y-suyama/FlexLogicMini_EVB/README.md

# FlexLogicMini Evalution Board
# Revision
## First Version

FTDI Driver Install
Thonny
tearteam
