y-suyama/FlexLogicMini_EVB/usrlib/LCMXO2-1200HC-4SG32I/LCMXO2-1200HC-4SG32I.stp

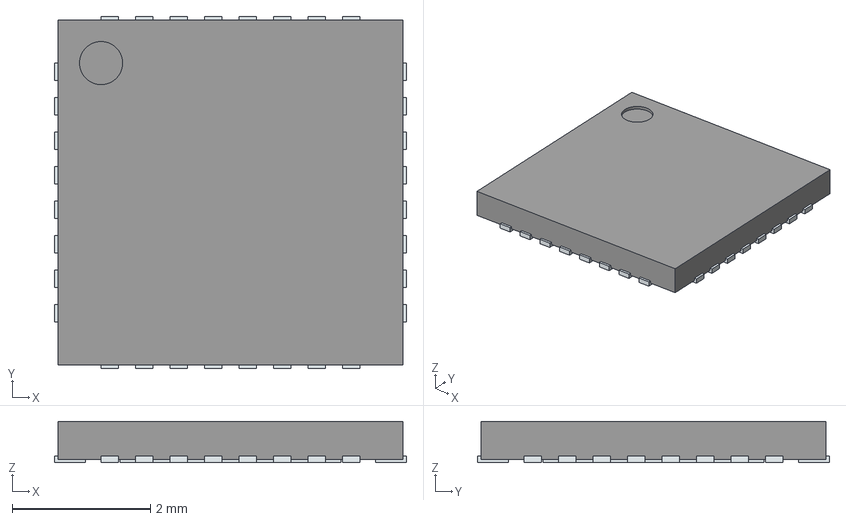
[picture p1: CAD file, 2025-06-15]
usrlib/LCMXO2-1200HC-4SG32I/LCMXO2-1200HC-4SG32I.stp
5.10 x 5.10 x 0.6 mm
ThermalPin
PinsArrayLR
PinsArrayTB
