y-suyama/FlexLogicMini_EVB/usrlib/SKRPACE010/SKRPACE010.step

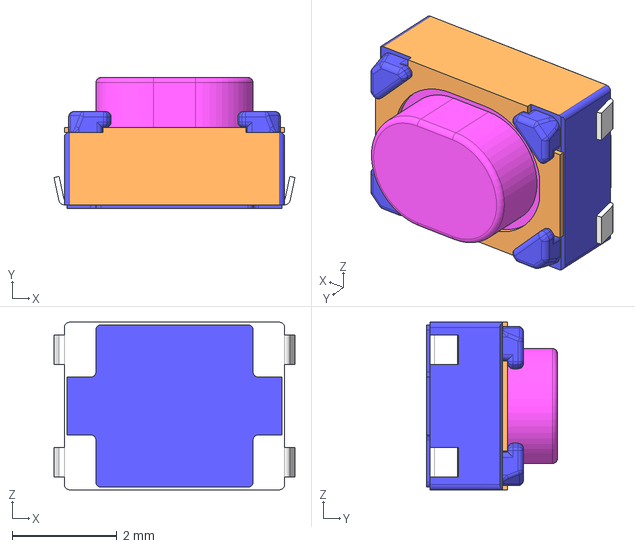
[picture p2: CAD file, 2025-06-15]
usrlib/SKRPACE010/SKRPACE010.step
4.60 x 2.50 x 3.20 mm
