y-suyama/FlexLogicMini_EVB/usrlib/UJC-HP-3-SMT-TR/UJC-HP-3-SMT-TR.step

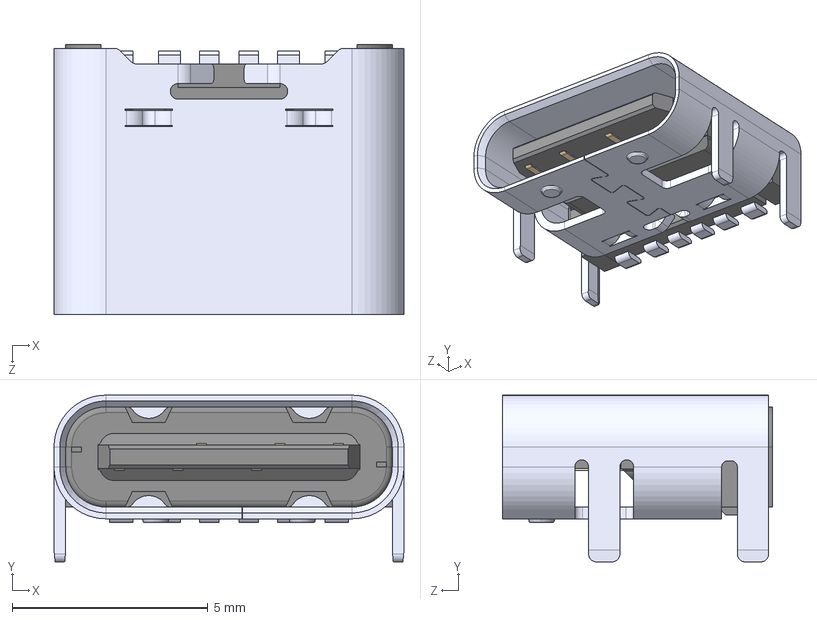
[picture p3: CAD file, 2025-06-15]
usrlib/UJC-HP-3-SMT-TR/UJC-HP-3-SMT-TR.step
8.94 x 4.26 x 6.90 mm
