y-suyama/FlexLogicMini_EVB/usrlib/W25Q16JVUXiQ/W25Q16JVUXIQ.step

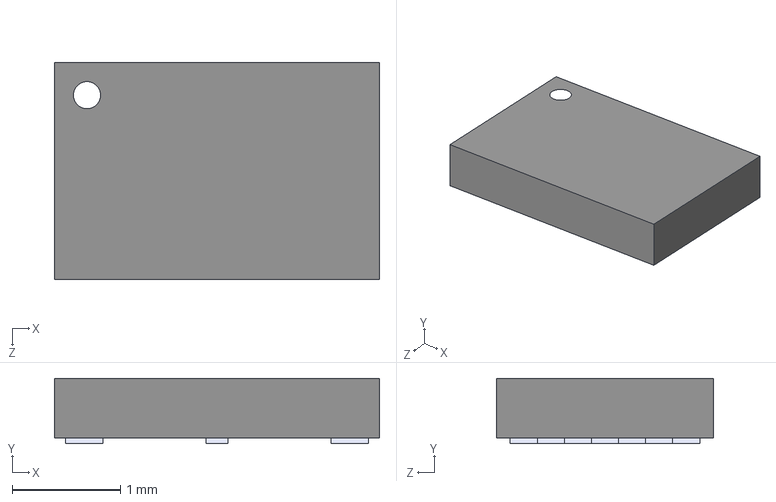
[picture p4: CAD file, 2025-06-15]
usrlib/W25Q16JVUXiQ/W25Q16JVUXIQ.step
3.00 x 0.6 x 2.00 mm
