y-suyama/FlexLogicMini_EVB/FlexLogicMini_EVB_schematic.pdf

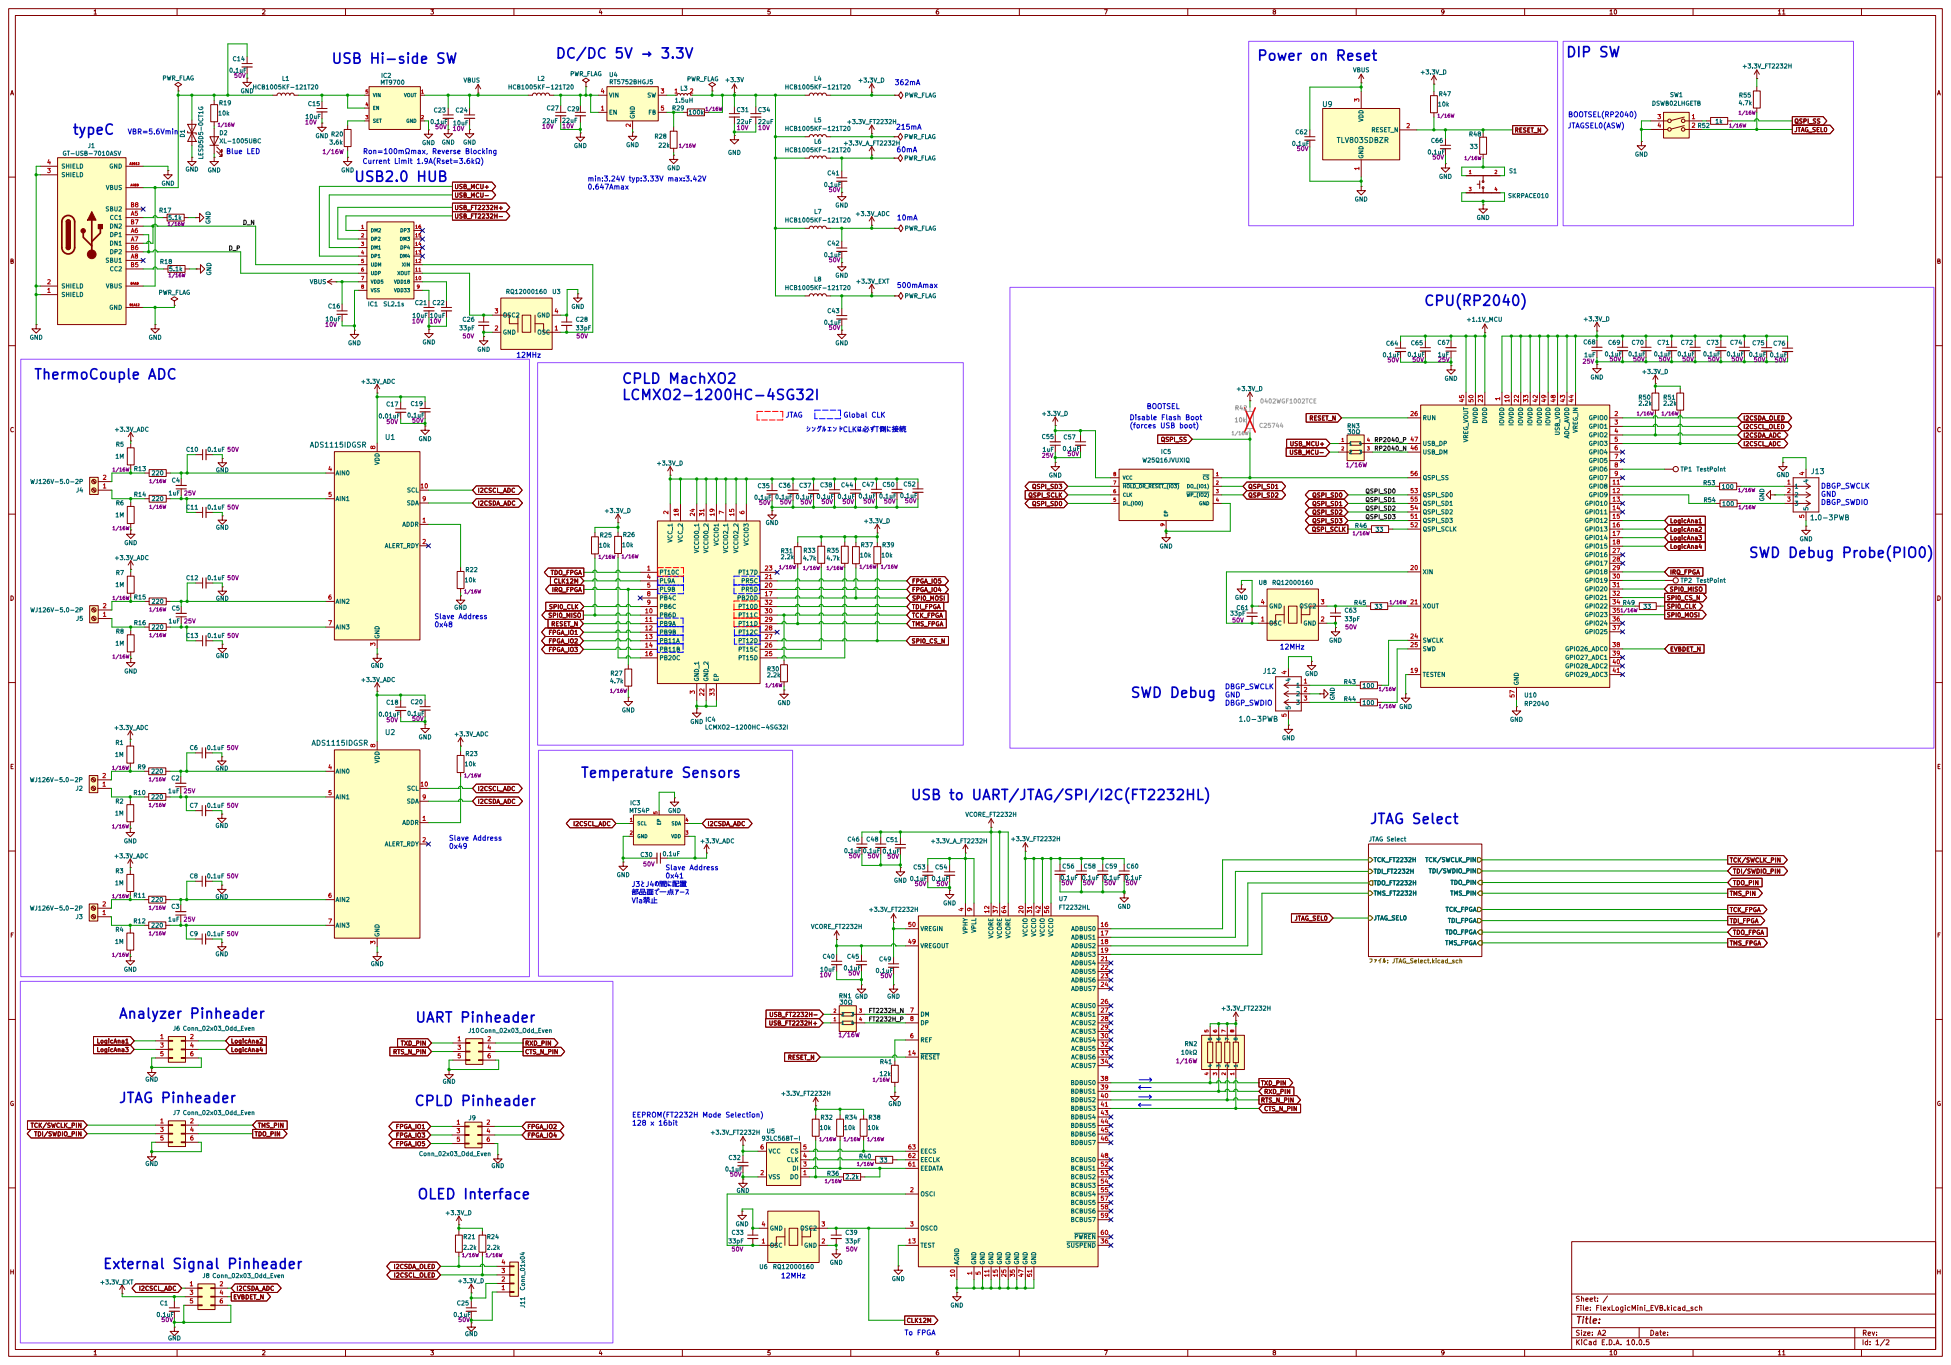
[picture p5: page 1]

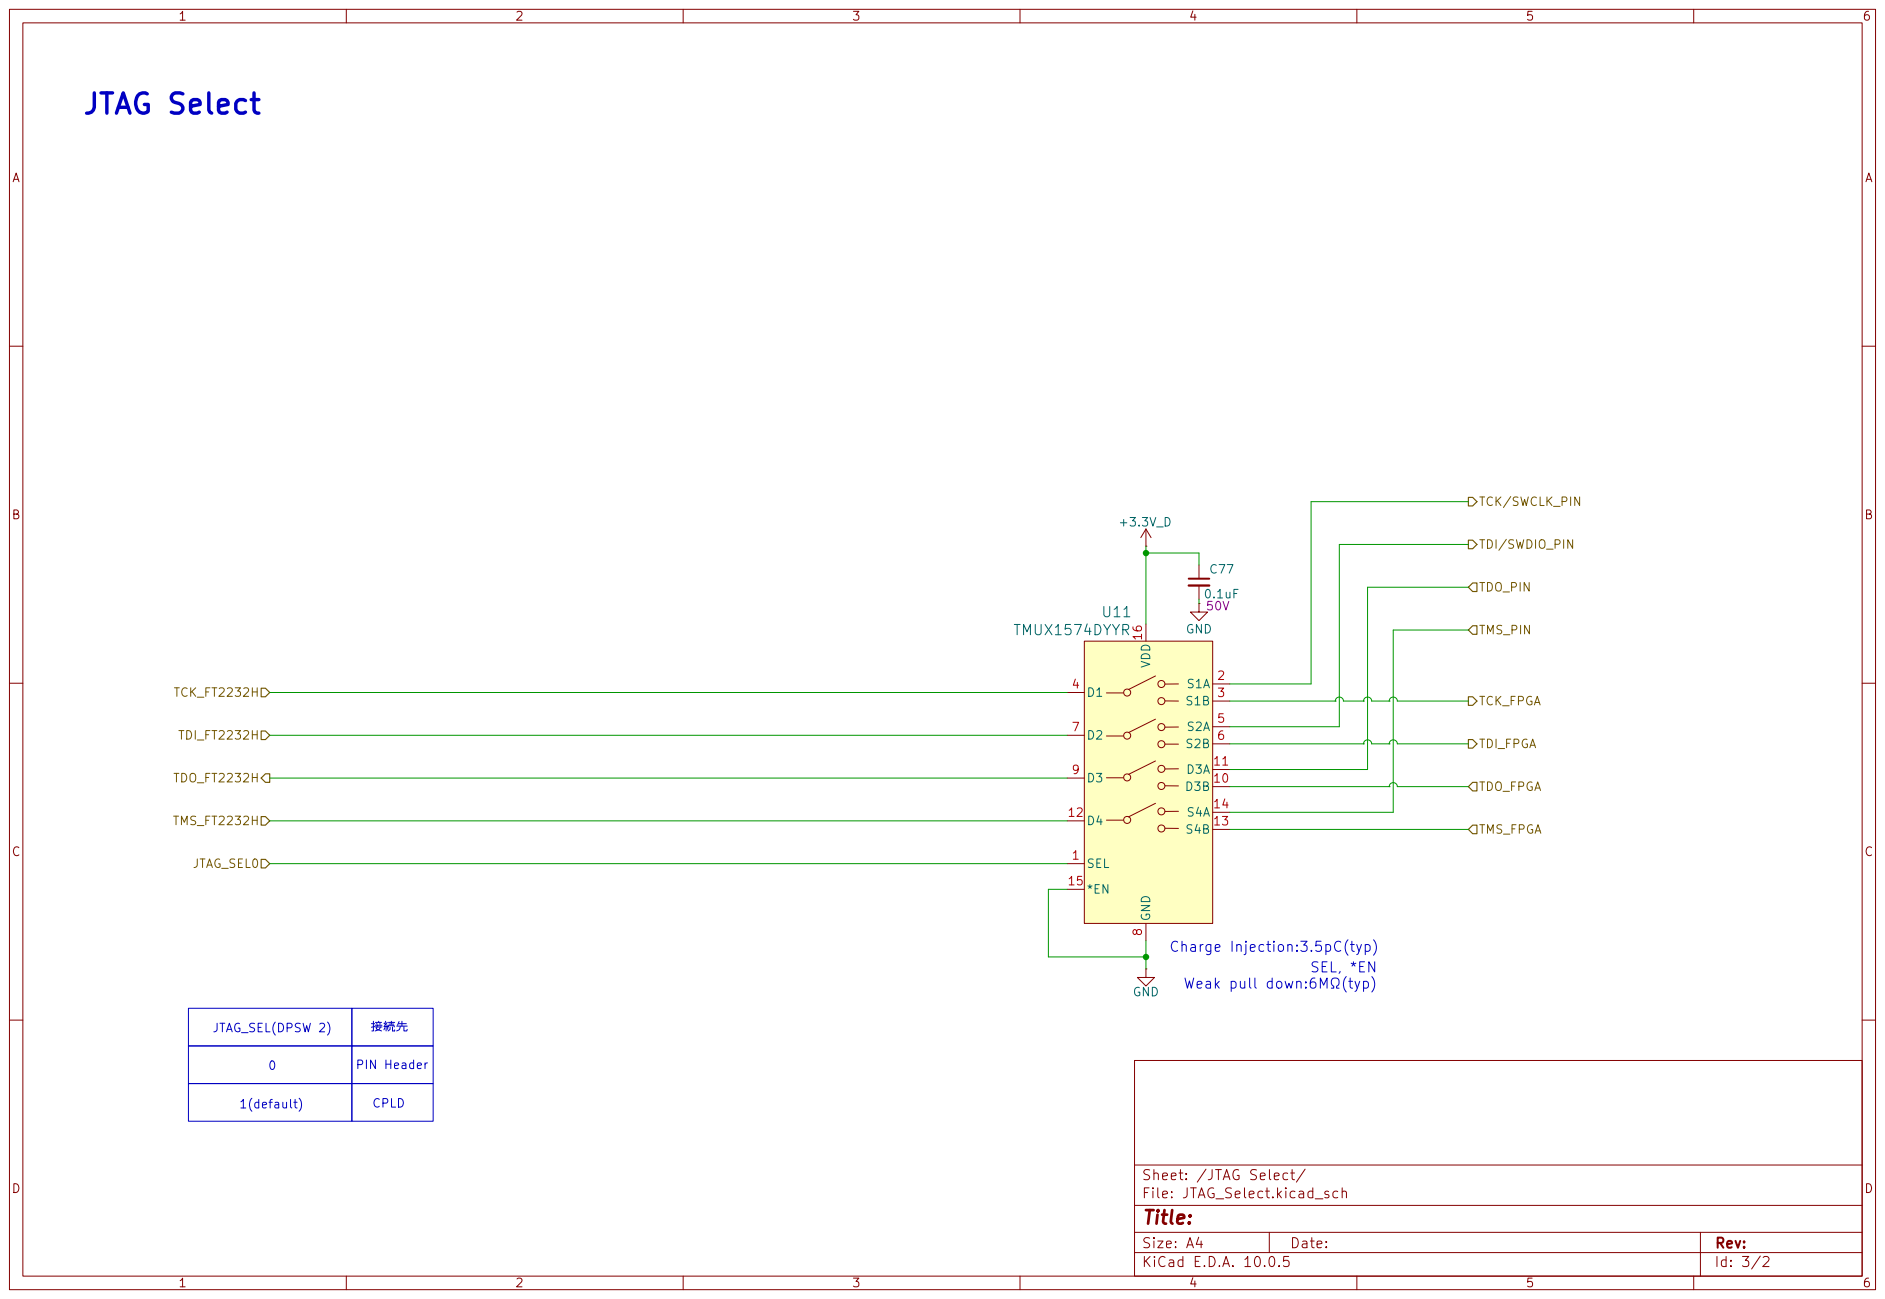
[picture p6: page 2]
