y-suyama/FlexLogicMini_EVB/FlexLogicMini_EVB_PCB.pdf

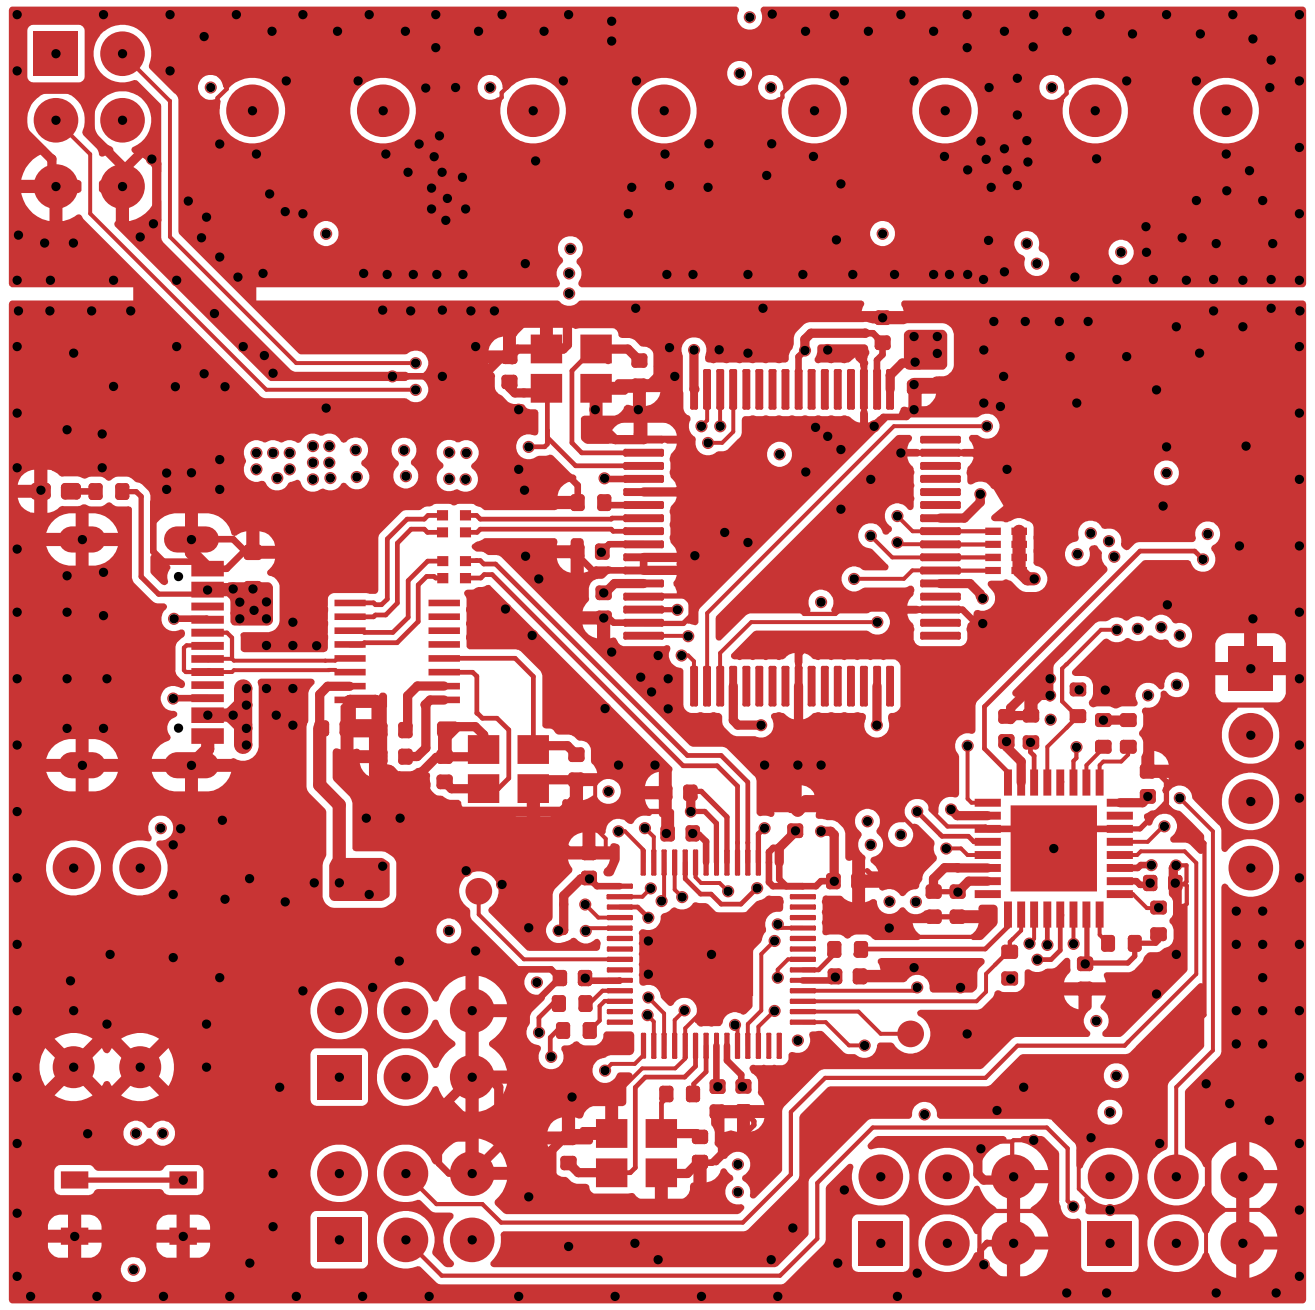
[picture p7: page 1]

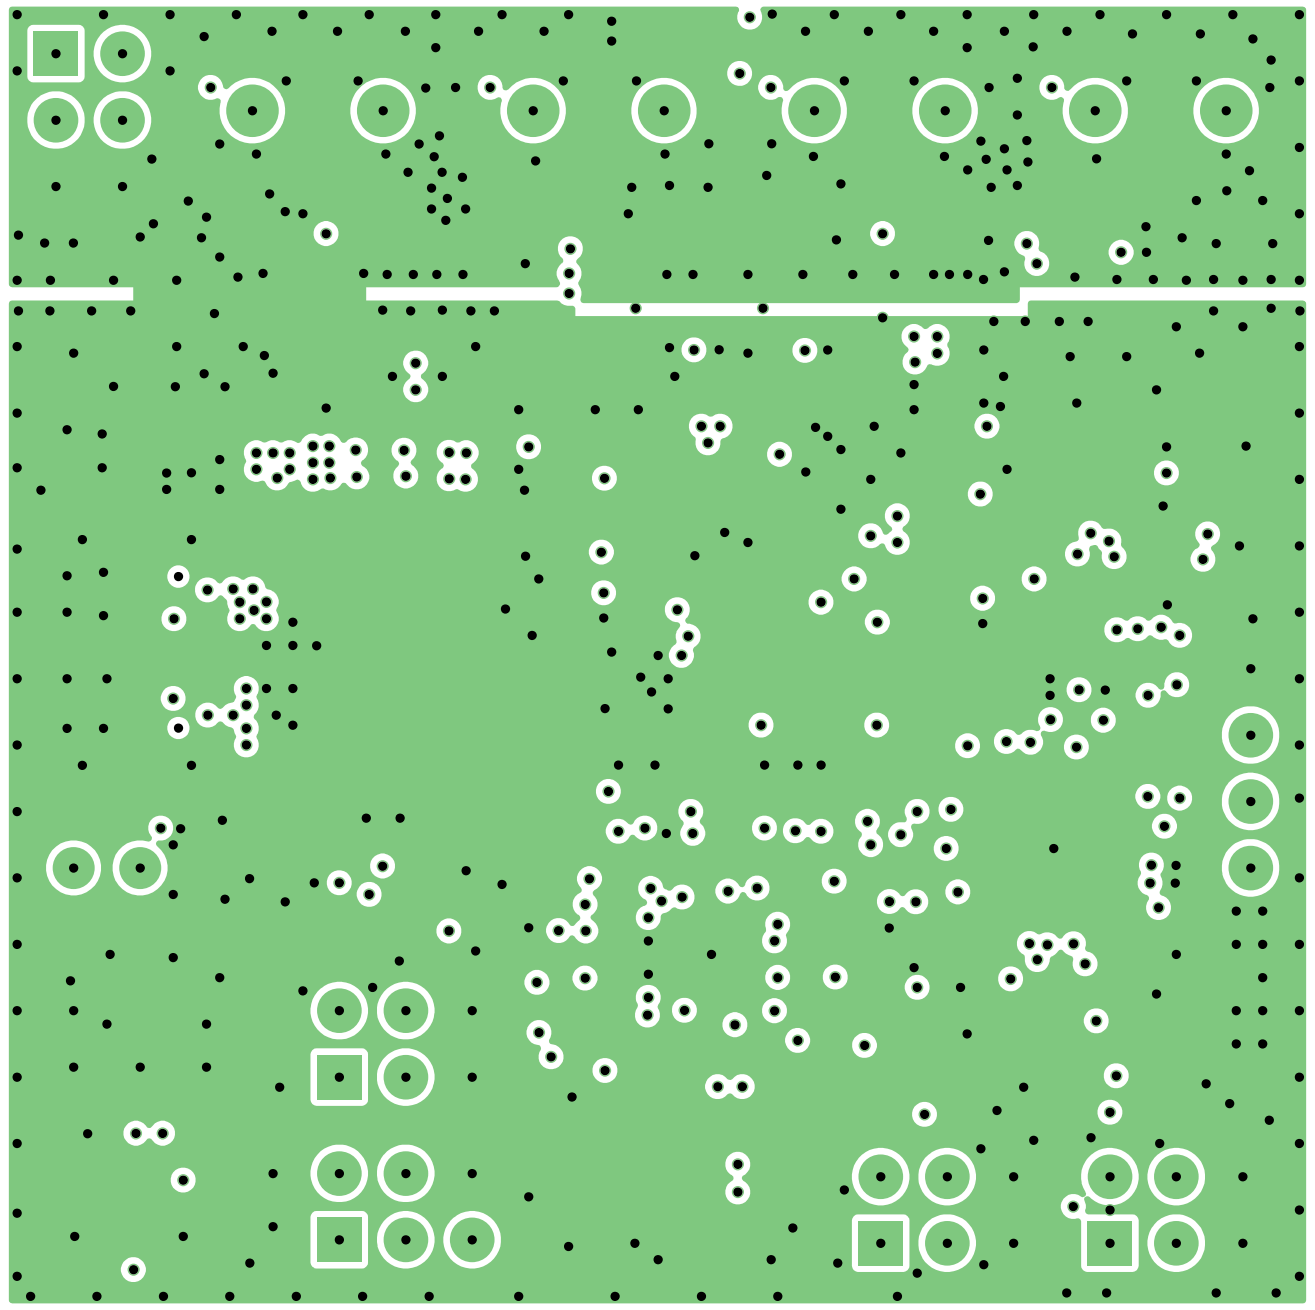
[picture p8: page 2]

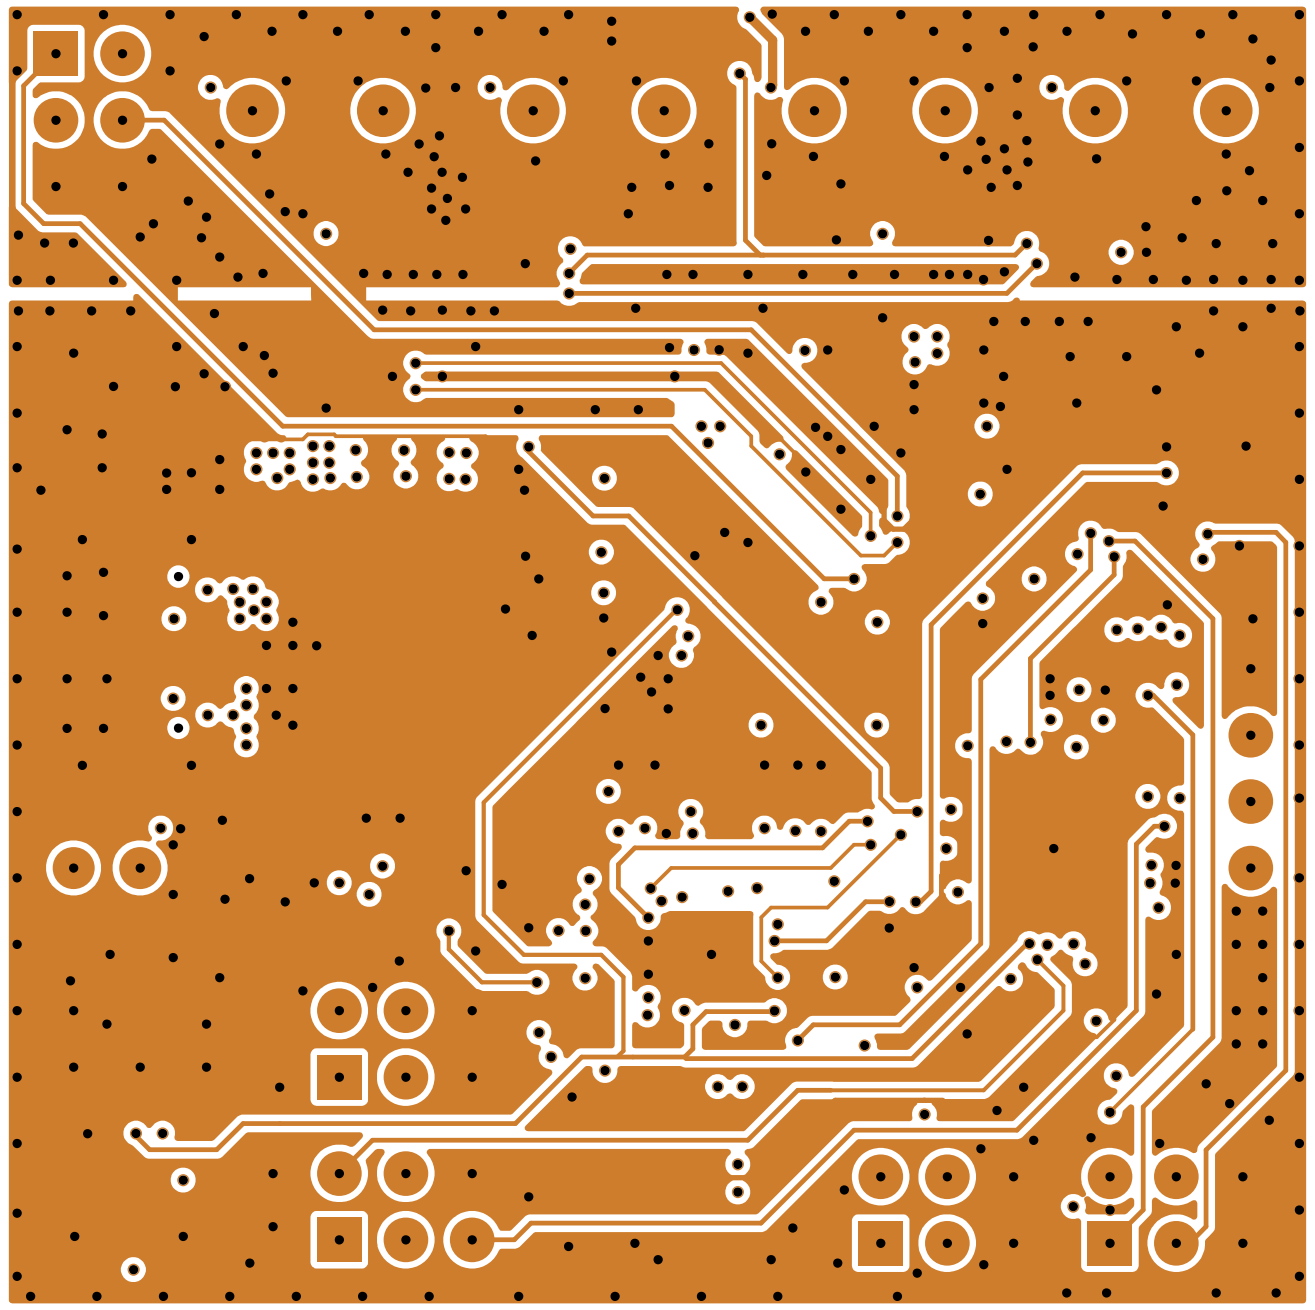
[picture p9: page 3]

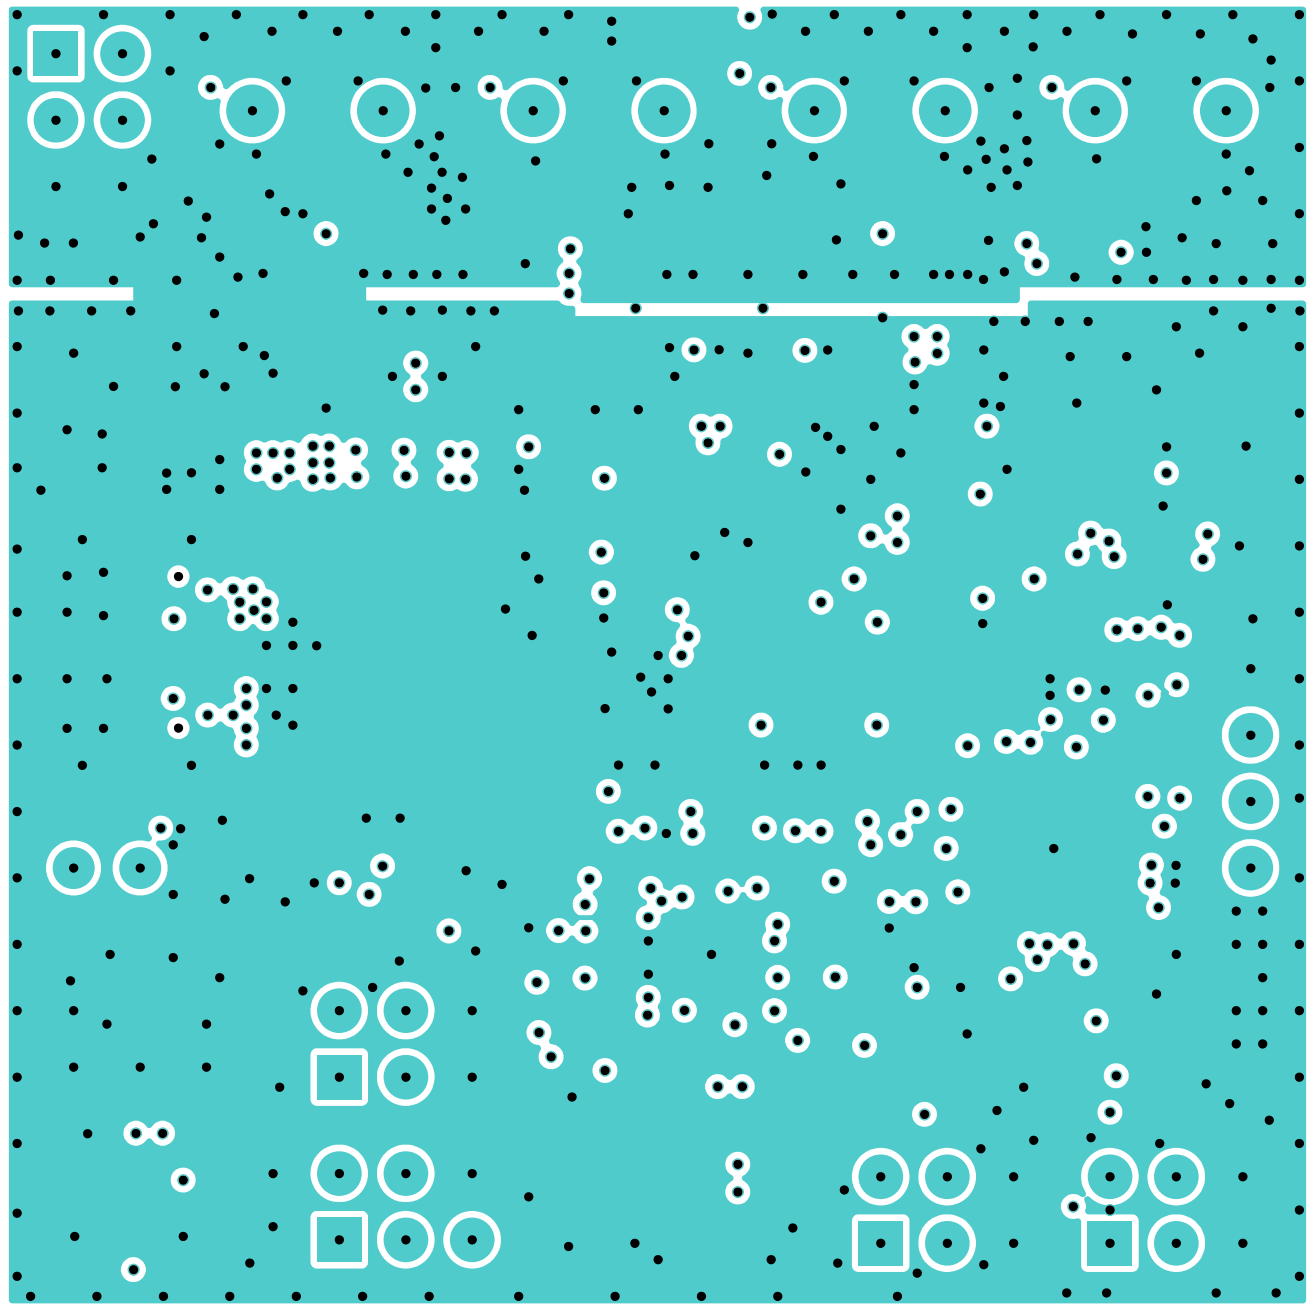
[picture p10: page 4]

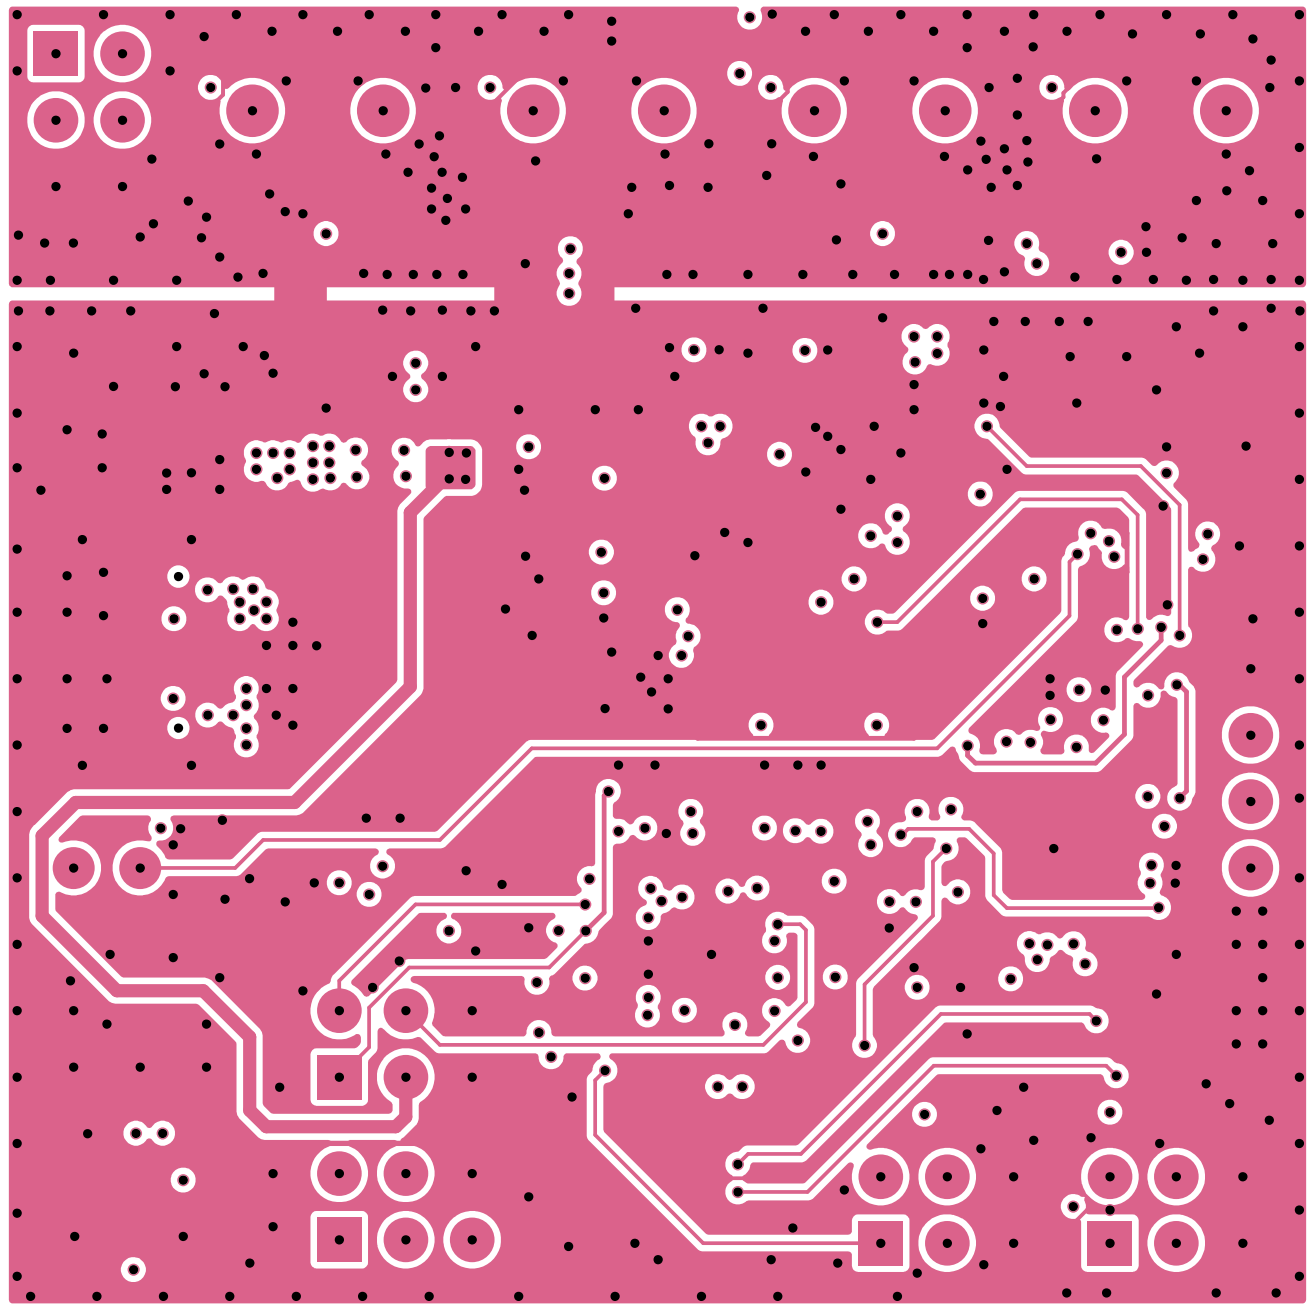
[picture p11: page 5]

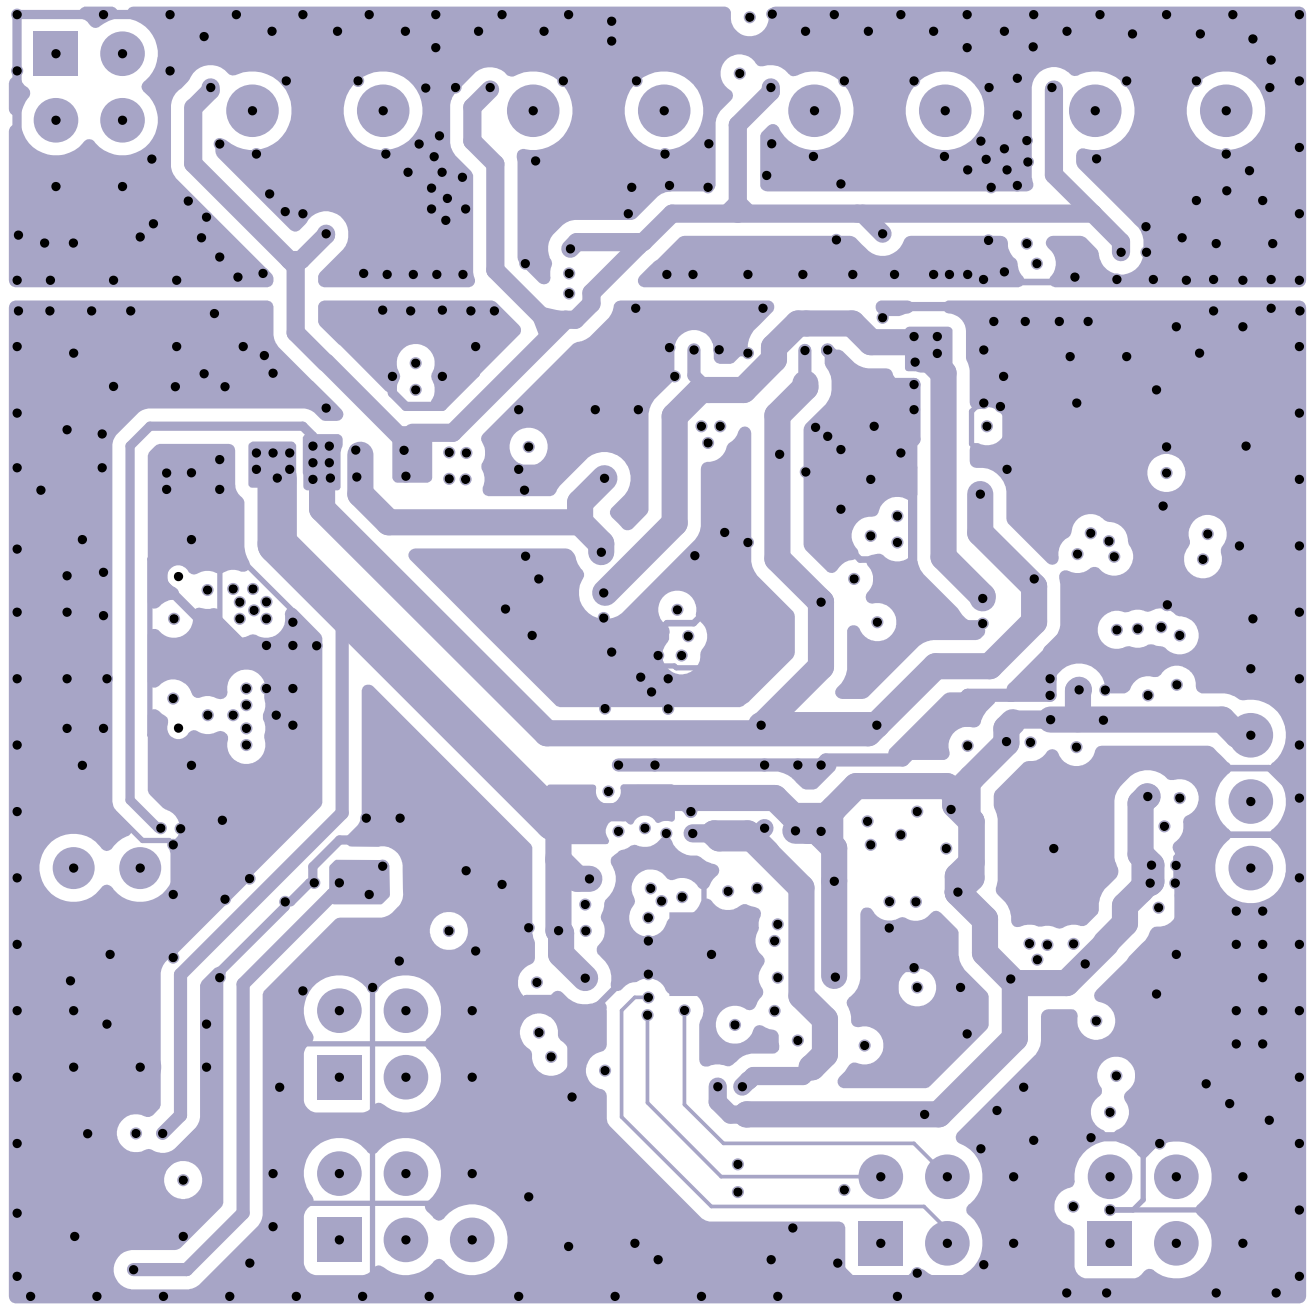
[picture p12: page 6]

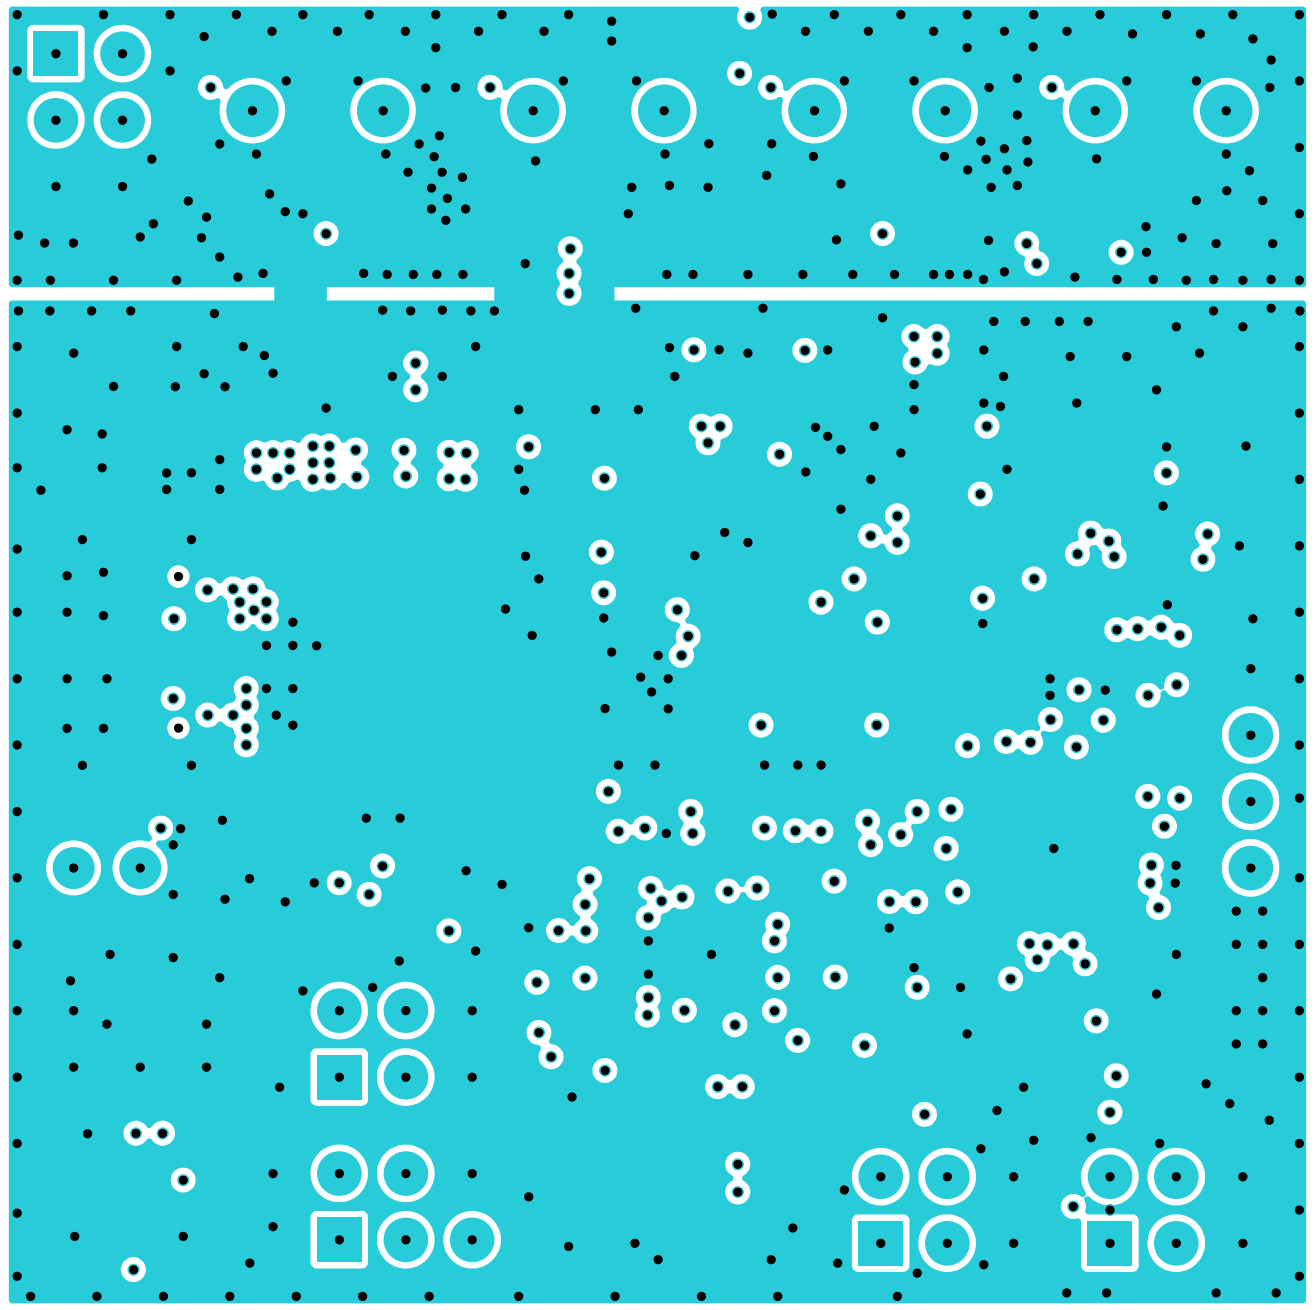
[picture p13: page 7]

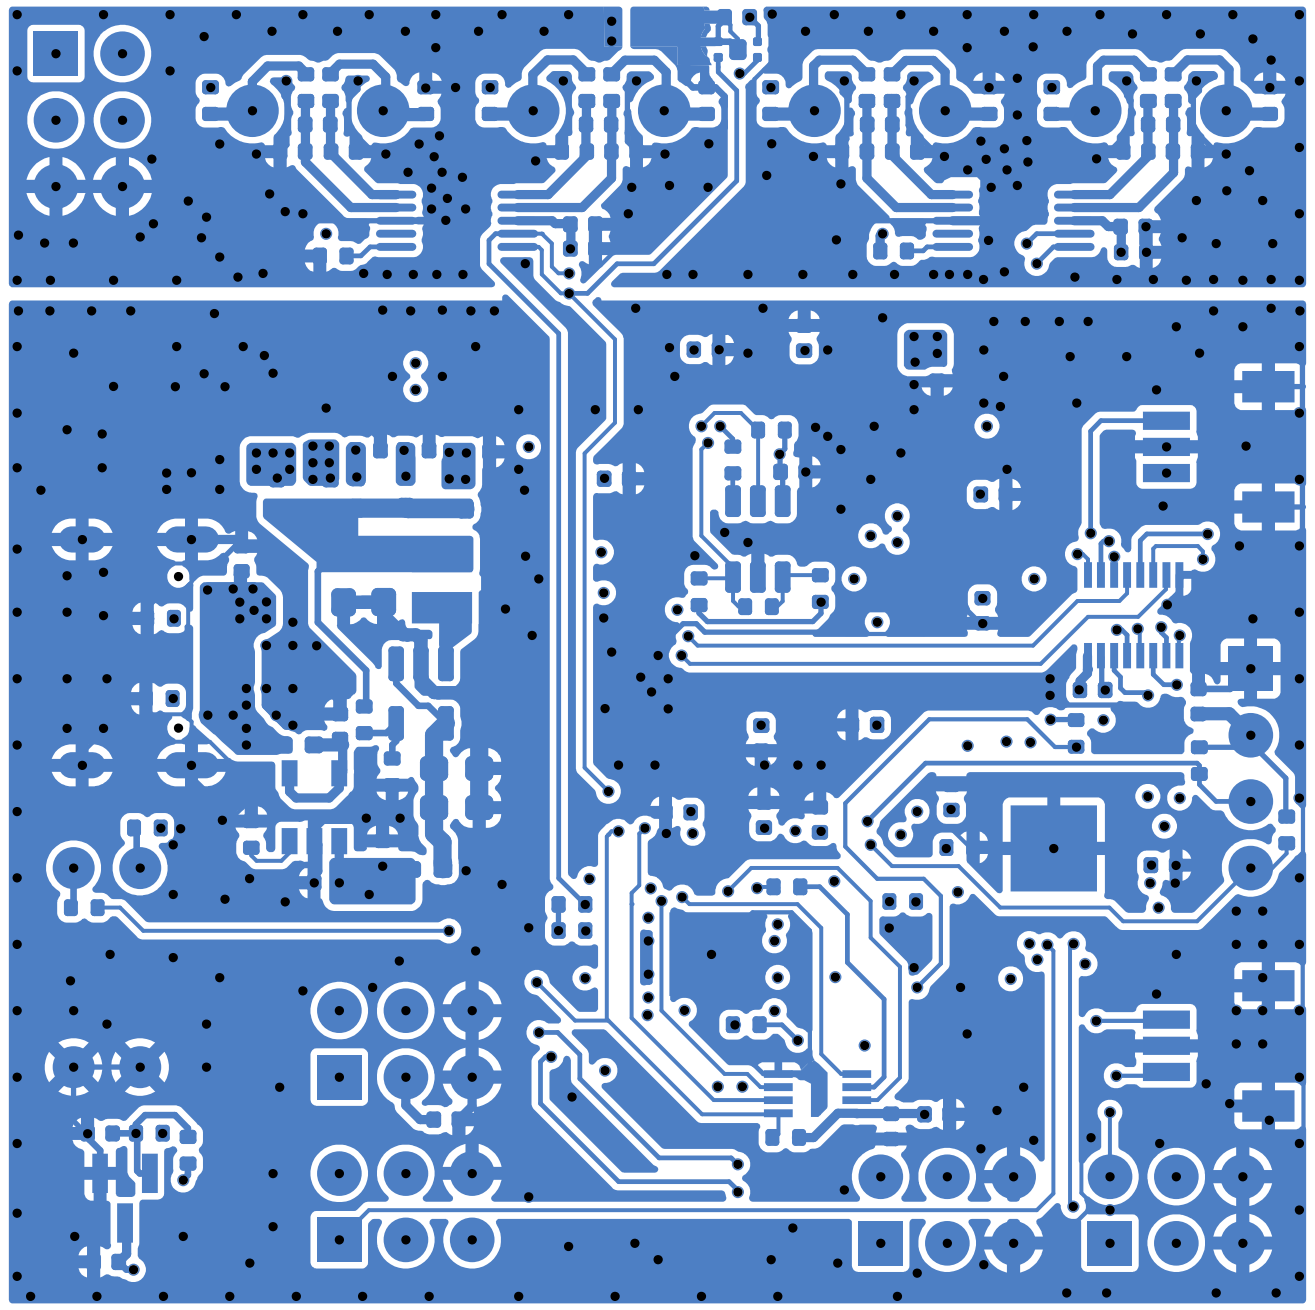
[picture p14: page 8]

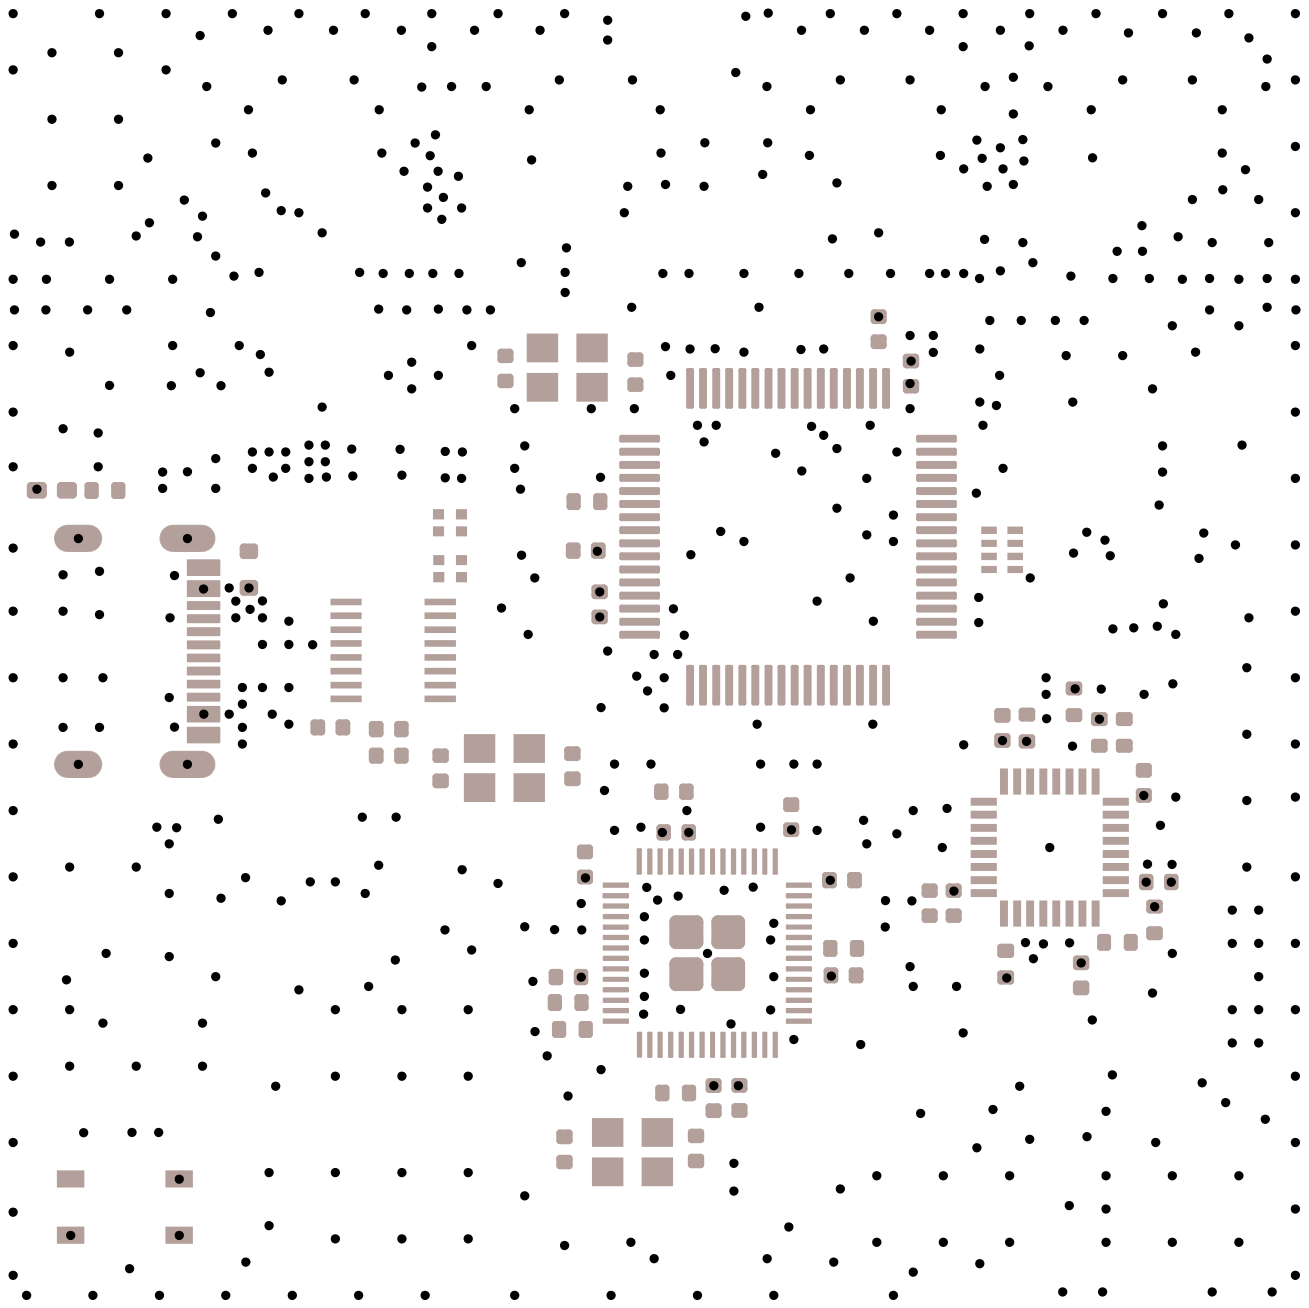
[picture p15: page 9]

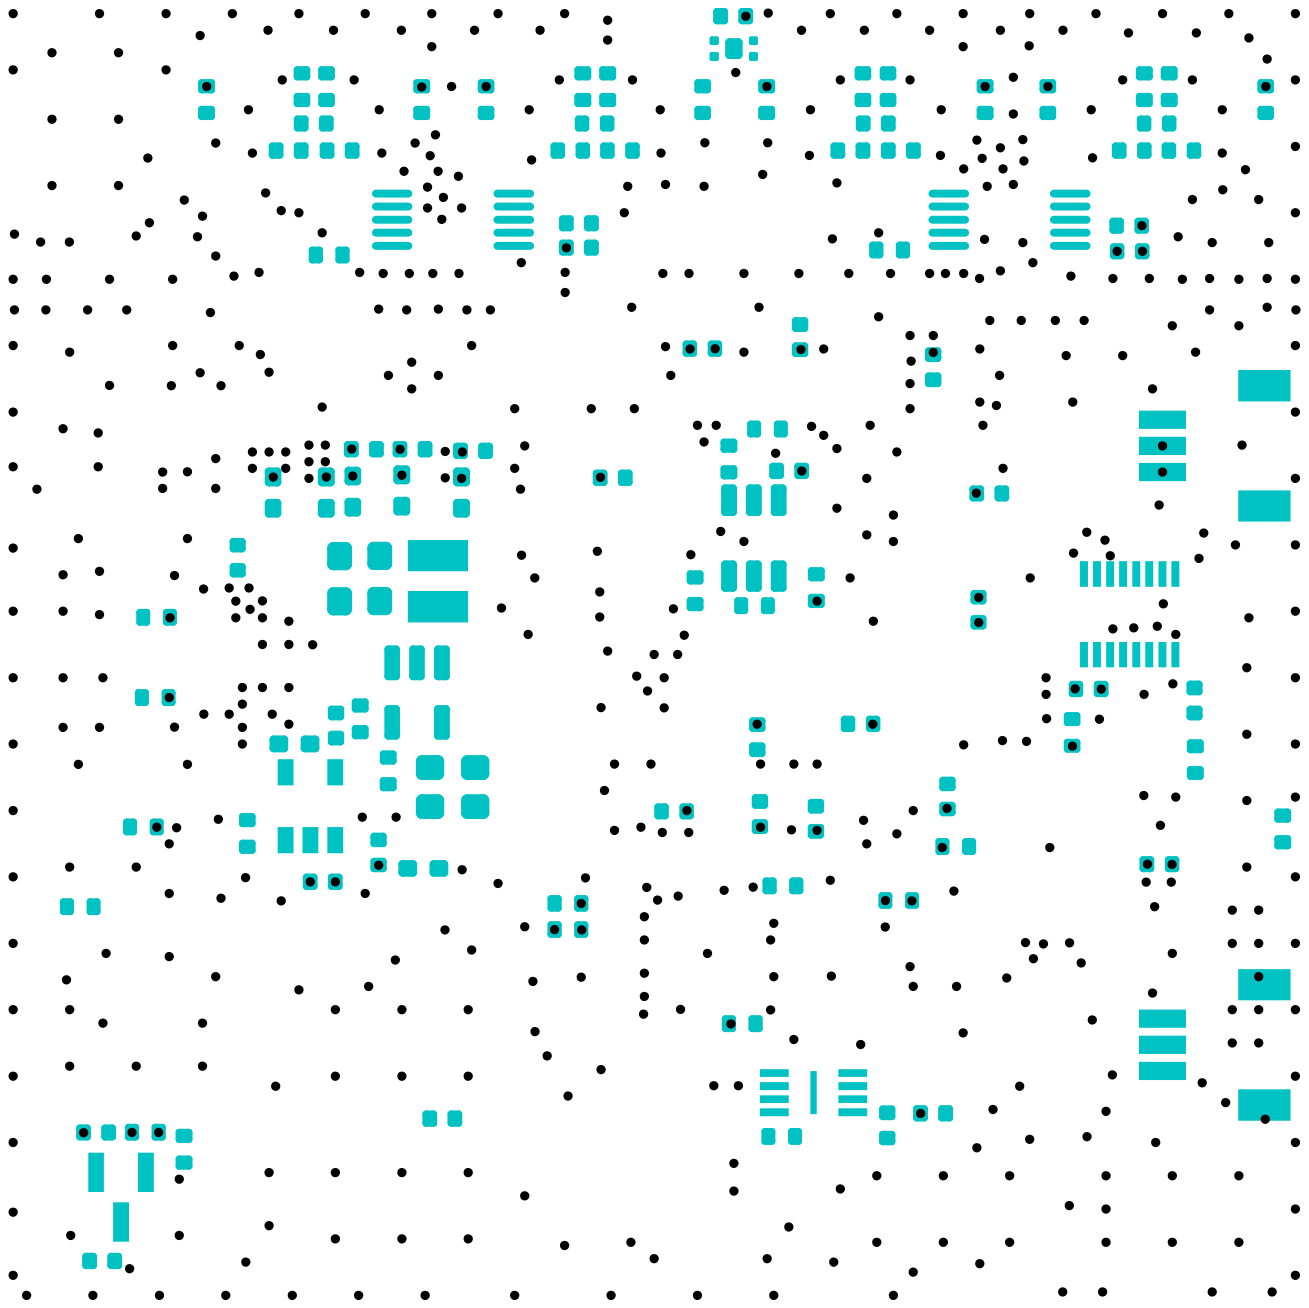
[picture p16: page 10]

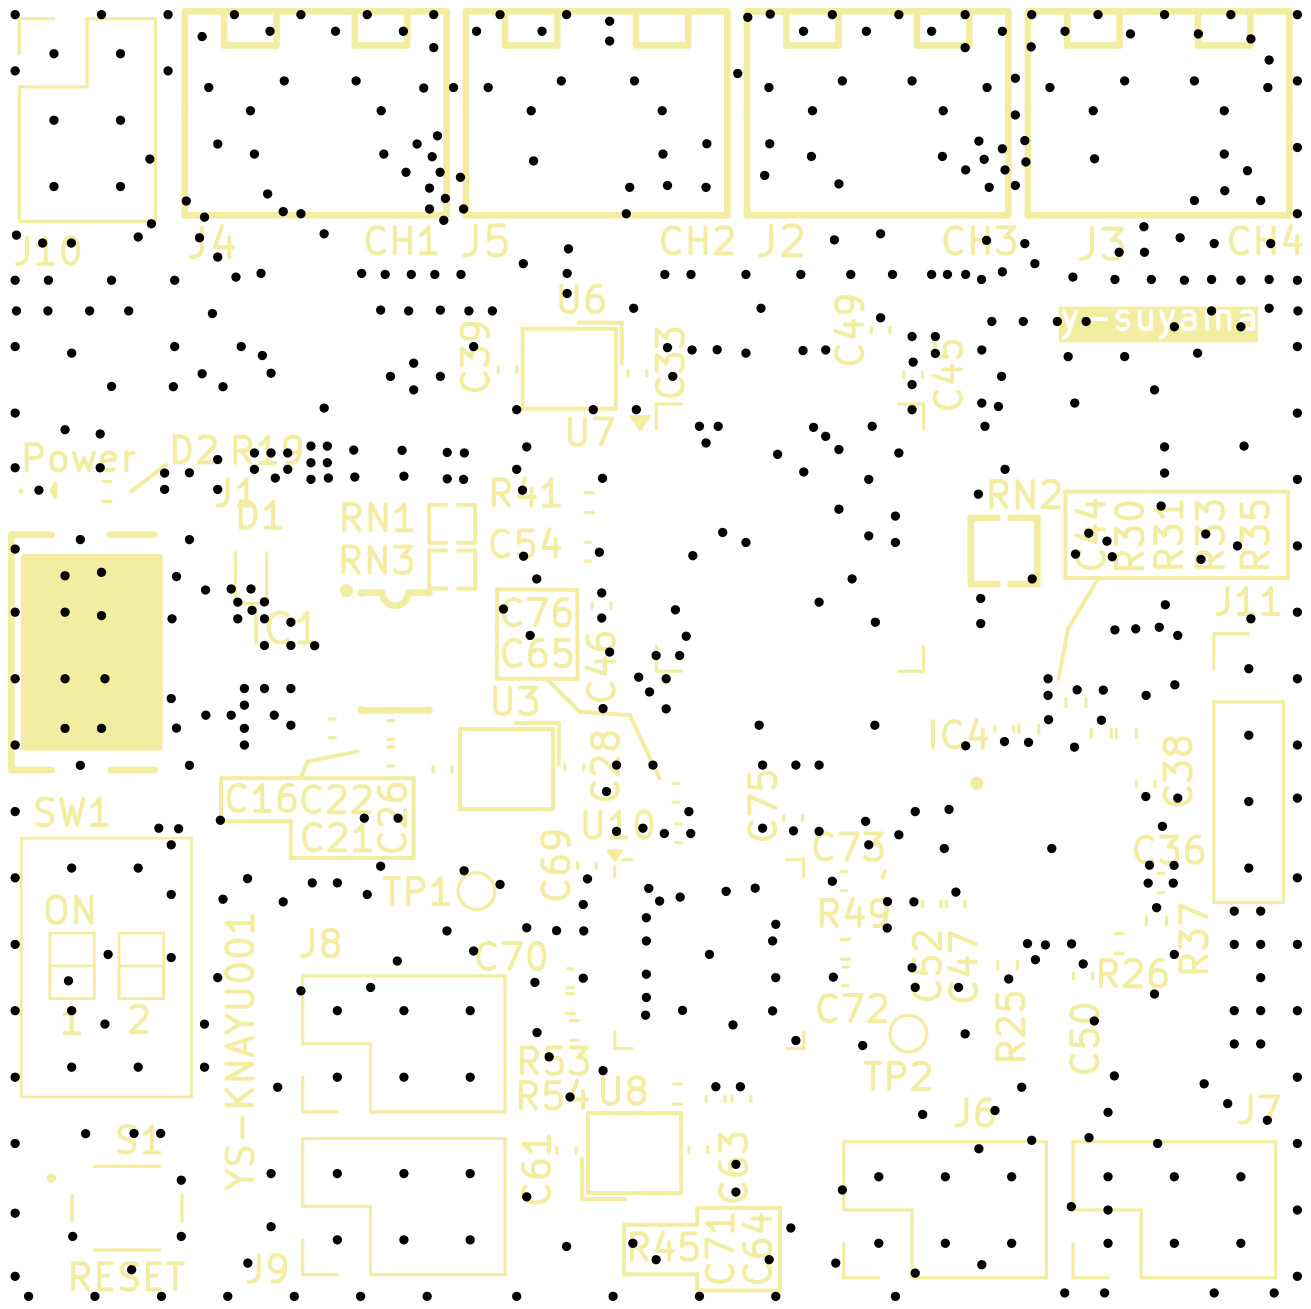
[picture p17: page 11]

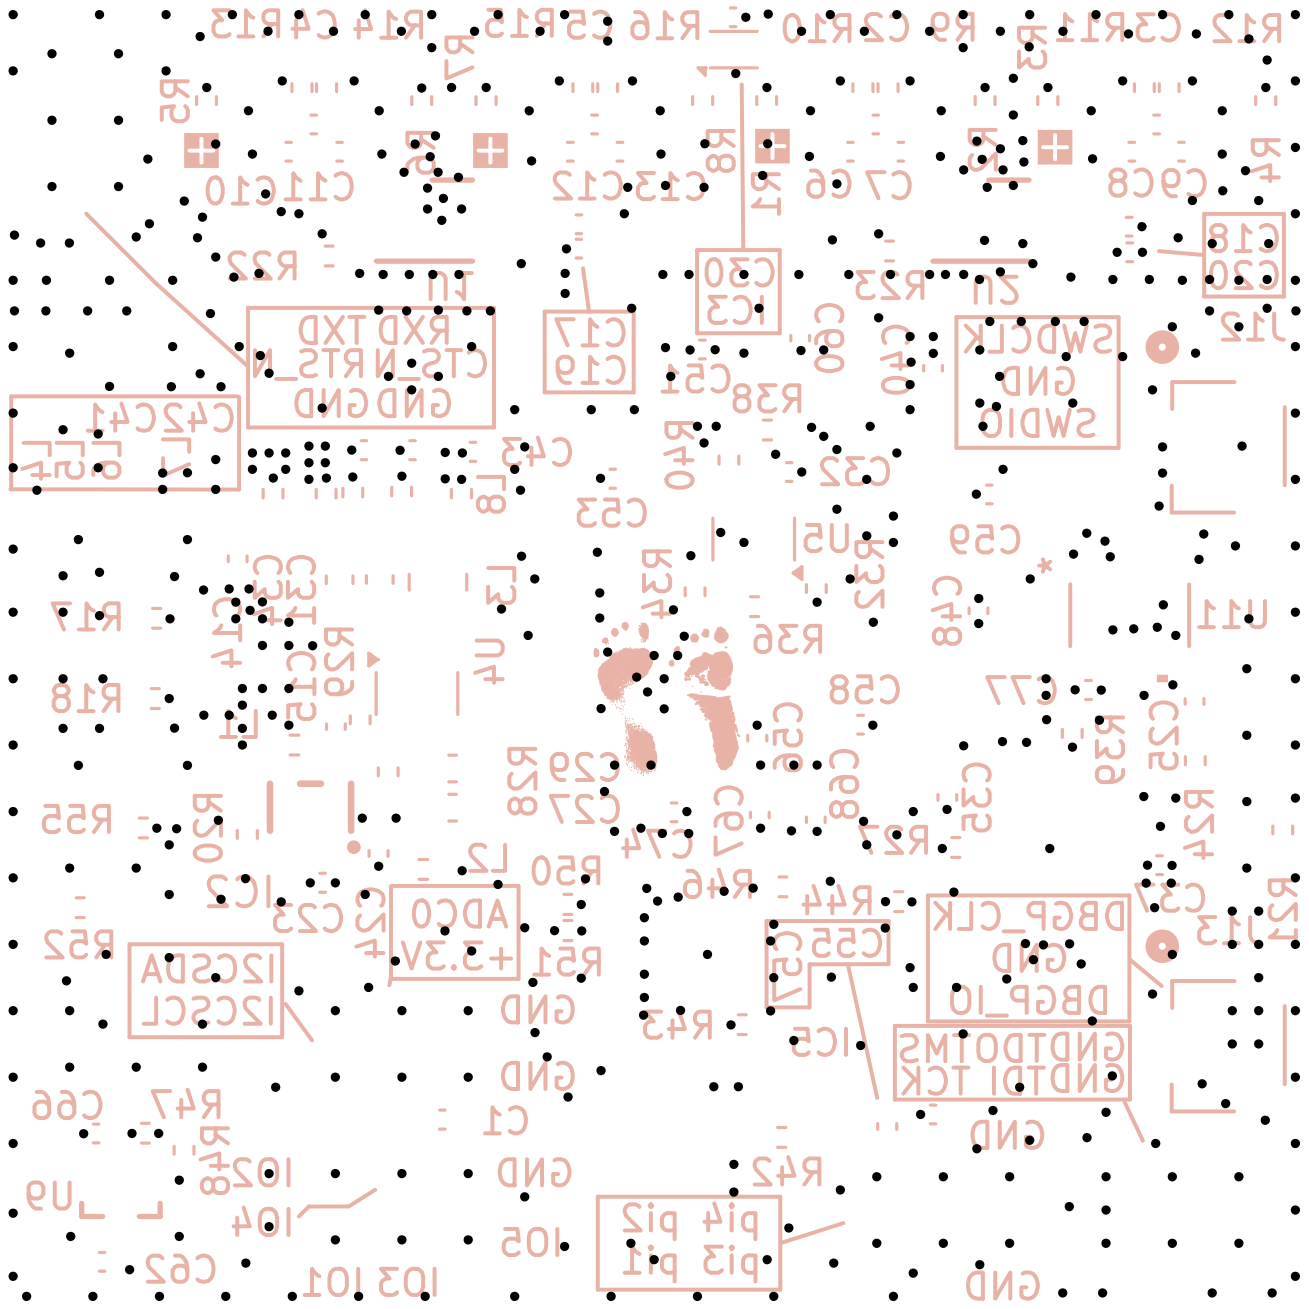
[picture p18: page 12]

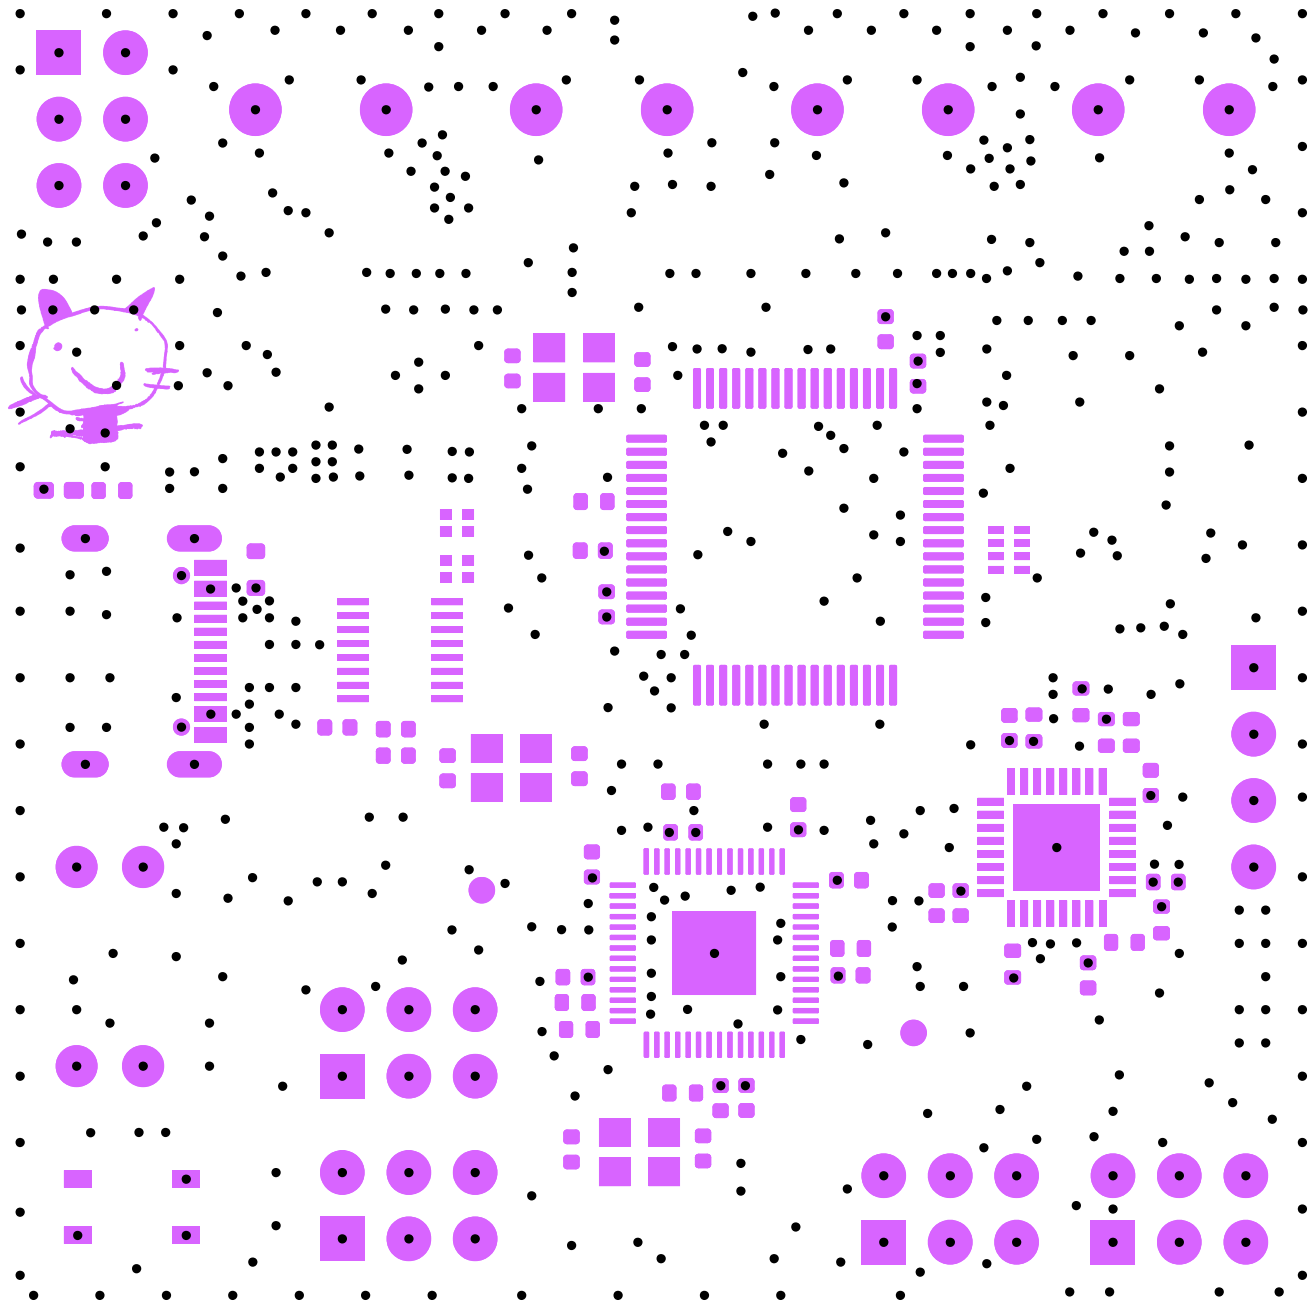
[picture p19: page 13]

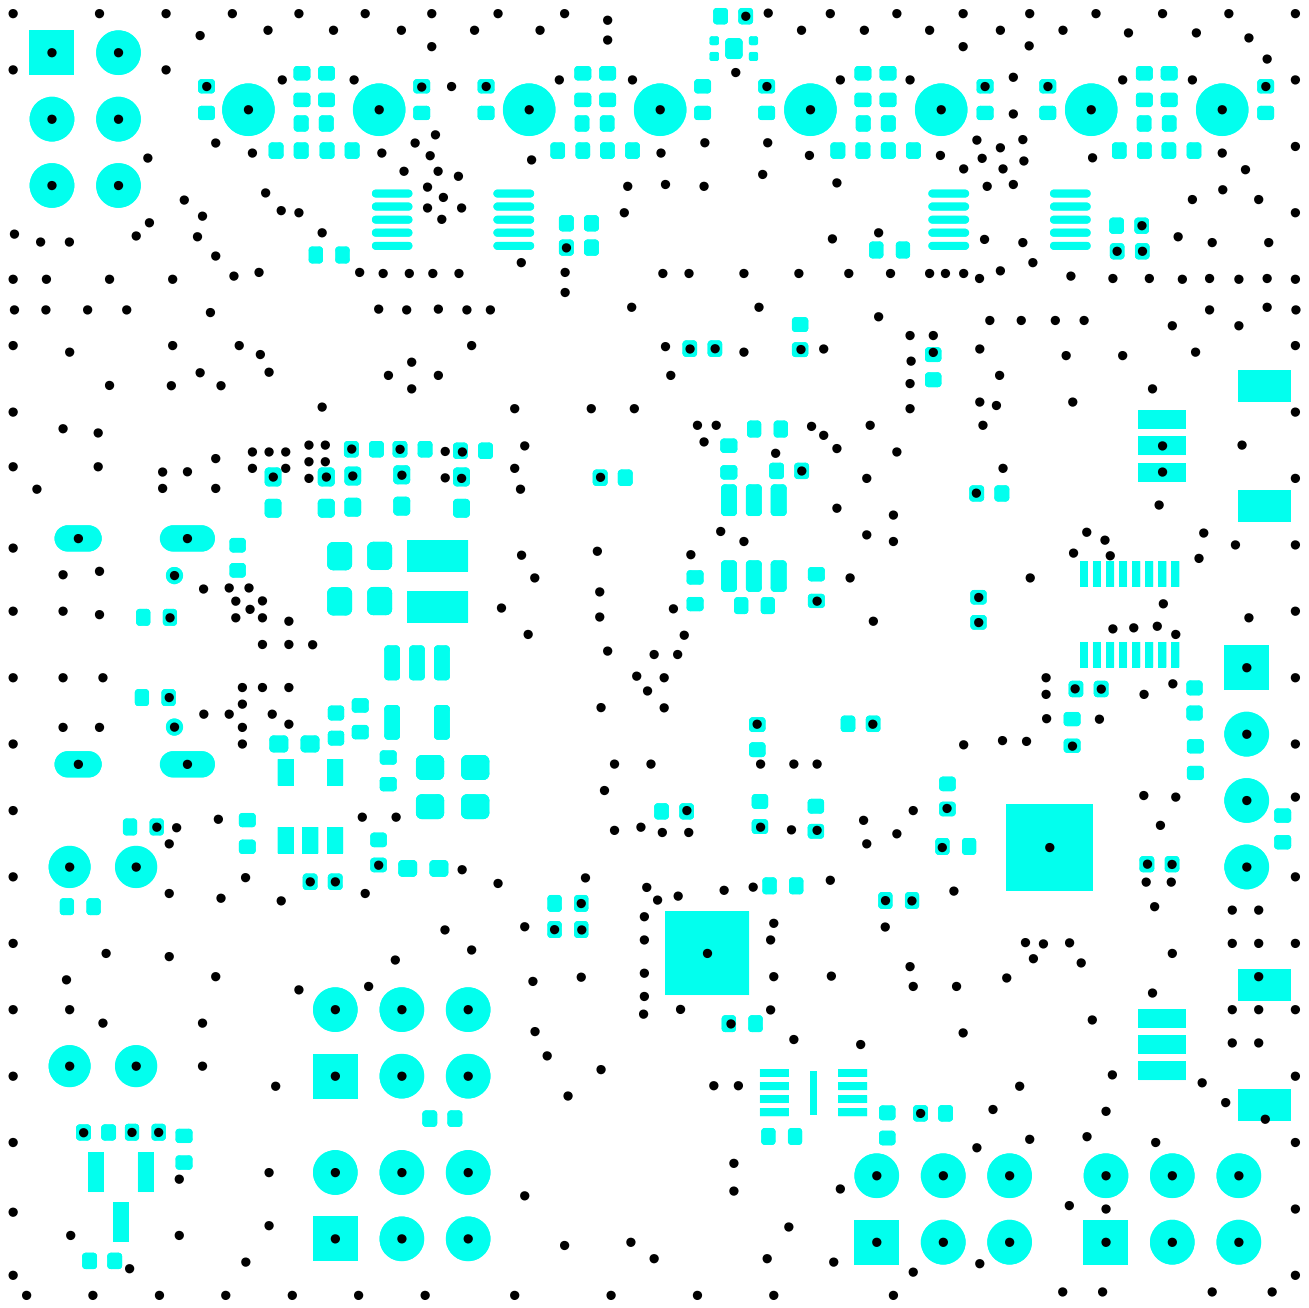
[picture p20: page 14]

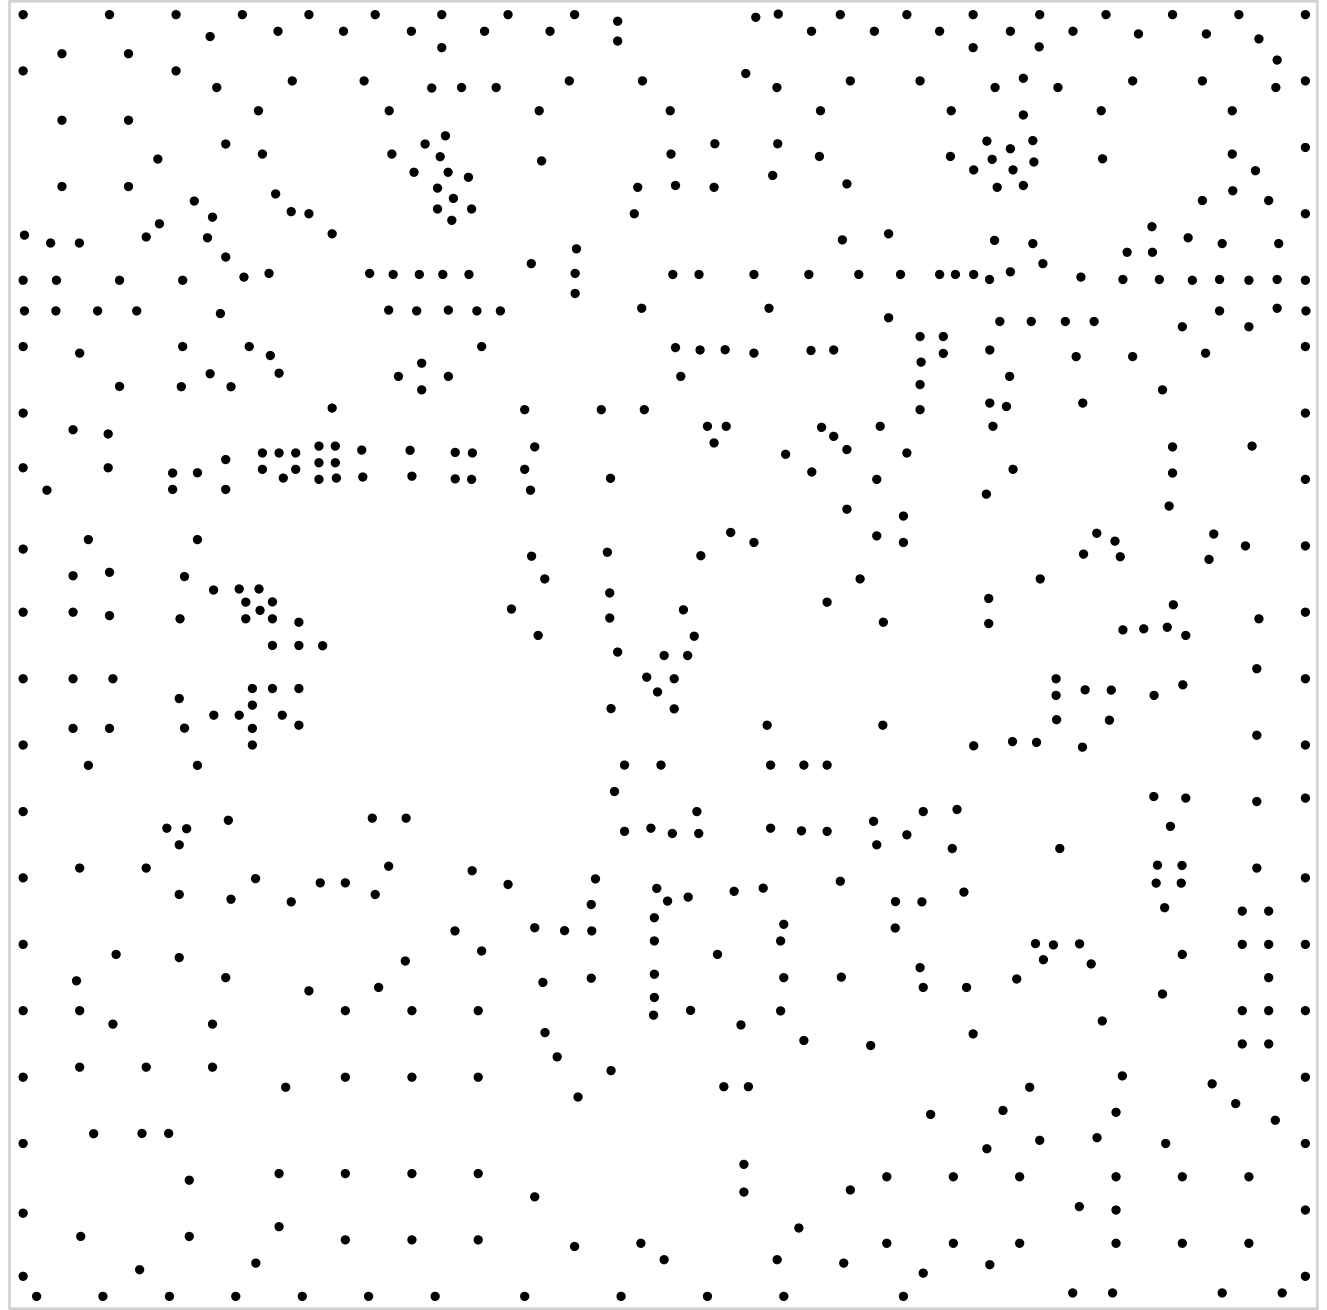
[picture p21: page 15]
