y-suyama/FlexLogicMini_EVB/(commit log)

2026-08-15 Final commit
    [FlexLogicMini_EVB.kicad_pcb, FlexLogicMini_EVB.kicad_sch, JTAG_Select.kicad_sch]
2026-08-16 V2 commit
    [FlexLogicMini_EVB.csv, FlexLogicMini_EVB.kicad_pcb, FlexLogicMini_EVB.kicad_sch, JTAG_Select.kicad_sch, bom.csv, designators.csv, positions.csv]
2026-09-27 V3 commit
    [BOM-FlexLogicMini_EVB.csv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]
